RawMechatronicsOrg/EasyScanner/charuco/boards/charuco_A0_10x14_80mm.pdf

## Easy Scanner ChArUco A0: 10 x 14 squares of 80 mm, markers 59.2 mm, DICT_5X5_100

App Settings: squares X 10, squares Y 14, square 80 mm, marker 59.2 mm, dictionary id 5. Print at 100 %, never "Fit to page". 100 mm
