RawMechatronicsOrg/EasyScanner/charuco/boards/charuco_A1_9x13_60mm.pdf

## Easy Scanner ChArUco A1: 9 x 13 squares of 60 mm, markers 44.4 mm, DICT_5X5_100

App Settings: squares X 9, squares Y 13, square 60 mm, marker 44.4 mm, dictionary id 5. Print at 100 %, never "Fit to page". 100 mm
