RawMechatronicsOrg/EasyScanner/cad/assembly/easy_scanner.step

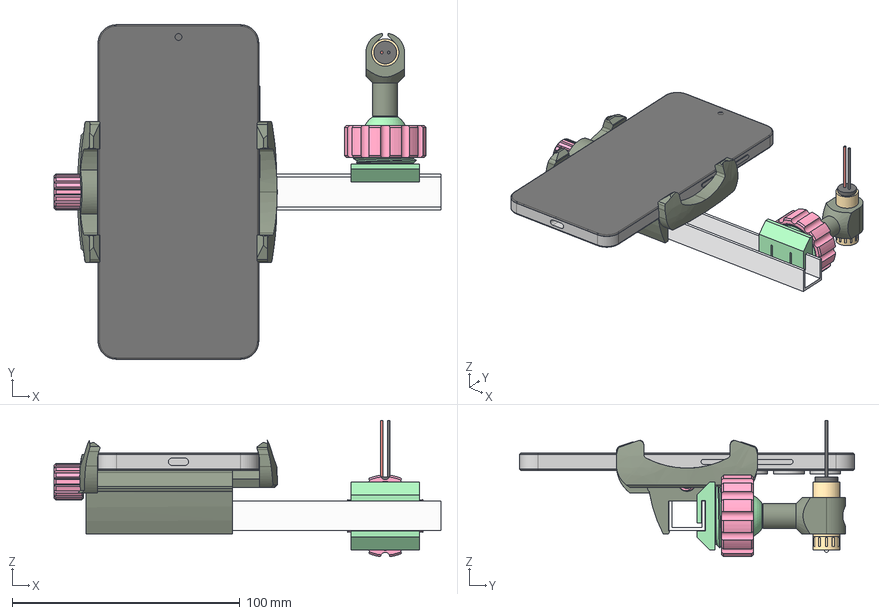
[picture p10: CAD file, 2026-10-28]
cad/assembly/easy_scanner.step
170.0 x 147.0 x 59.9 mm
Phone Clamp Lower
Phone Clamp Upper
S24 body 01
S24 body 02
S24 body 03
S24 body 04
S24 body 05
S24 body 06
S24 body 07
S24 body 08
S24 body 09
S24 body 10
S24 body 11
S24 body 12
Profile 16x13 U
Phone Clamp Screw Bottom
Phone Clamp Screw Top
Phone Clamp Knurled Head
Laser Mount Clip
Laser Mount Ball
Laser Mount Nut
Laser Clamp
Laser body 01
Laser body 02
Laser body 03
Laser body 04
Laser body 05
Laser body 06
