RawMechatronicsOrg/EasyScanner/cad/export/ball_mount_flange_clip.stl

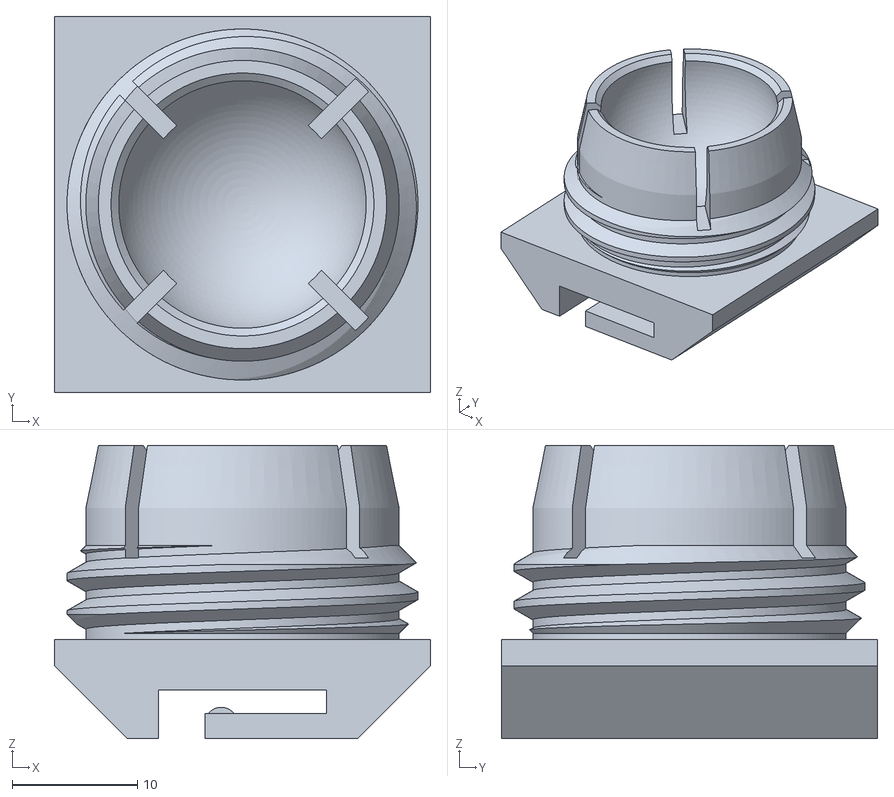
[picture p11: CAD file, 2026-10-28]
cad/export/ball_mount_flange_clip.stl
30.0 x 30.0 x 23.4
