RawMechatronicsOrg/EasyScanner/cad/phone-clamp/export/updated_phone_clamp_upper_no_plate.stl

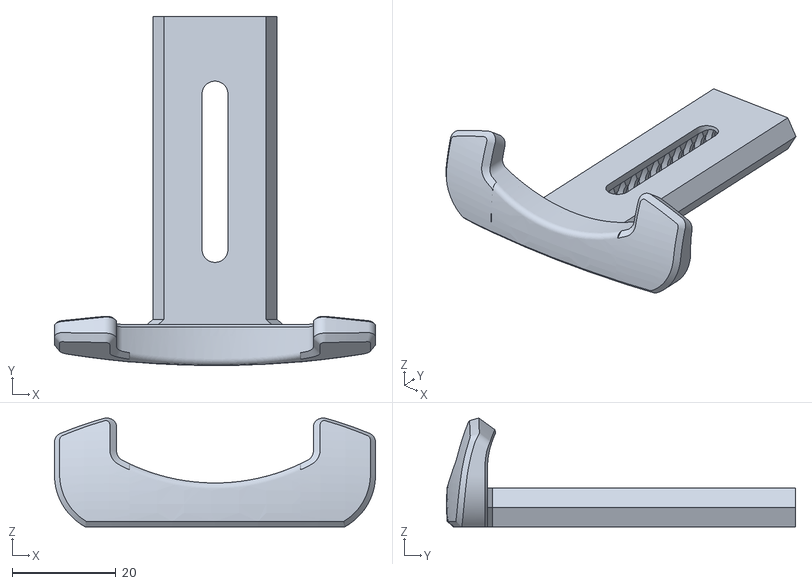
[picture p12: CAD file, 2026-10-19]
cad/phone-clamp/export/updated_phone_clamp_upper_no_plate.stl
62.0 x 67.4 x 21.0
