RawMechatronicsOrg/EasyScanner/cad/export/ball_mount_laser_clamp.stl

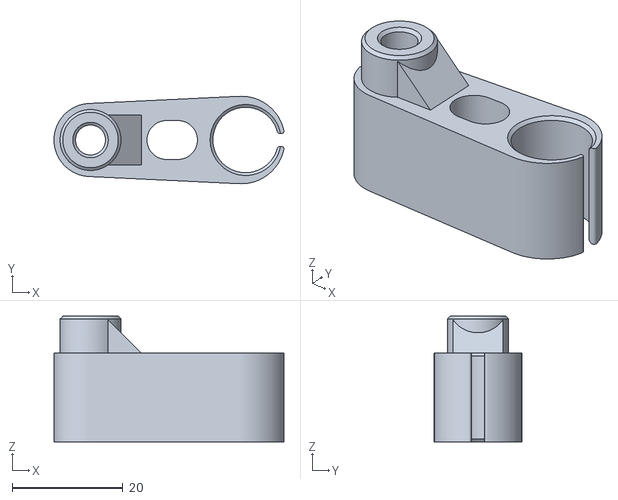
[picture p13: CAD file, 2026-10-19]
cad/export/ball_mount_laser_clamp.stl
41.5 x 15.8 x 22.7
