RawMechatronicsOrg/EasyScanner/cad/phone-clamp/source/updated_phone_clamp_knurl_head_hole.stl

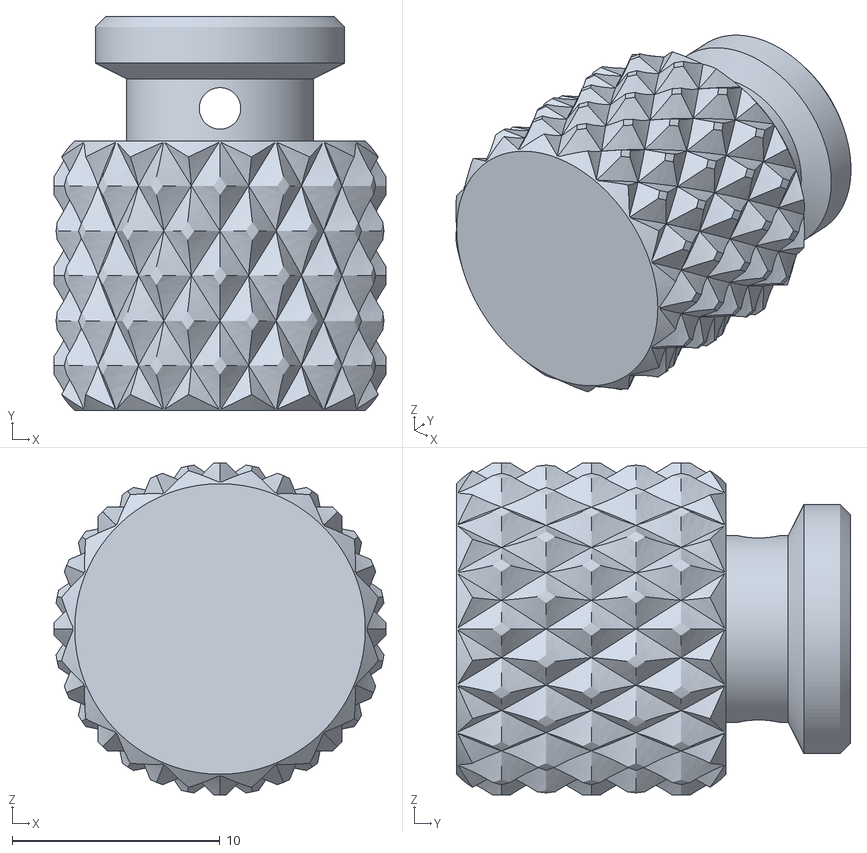
[picture p14: CAD file, 2026-10-19]
cad/phone-clamp/source/updated_phone_clamp_knurl_head_hole.stl
16.0 x 19.0 x 16.0
