RawMechatronicsOrg/EasyScanner/cad/export/ball_mount_ball.stl

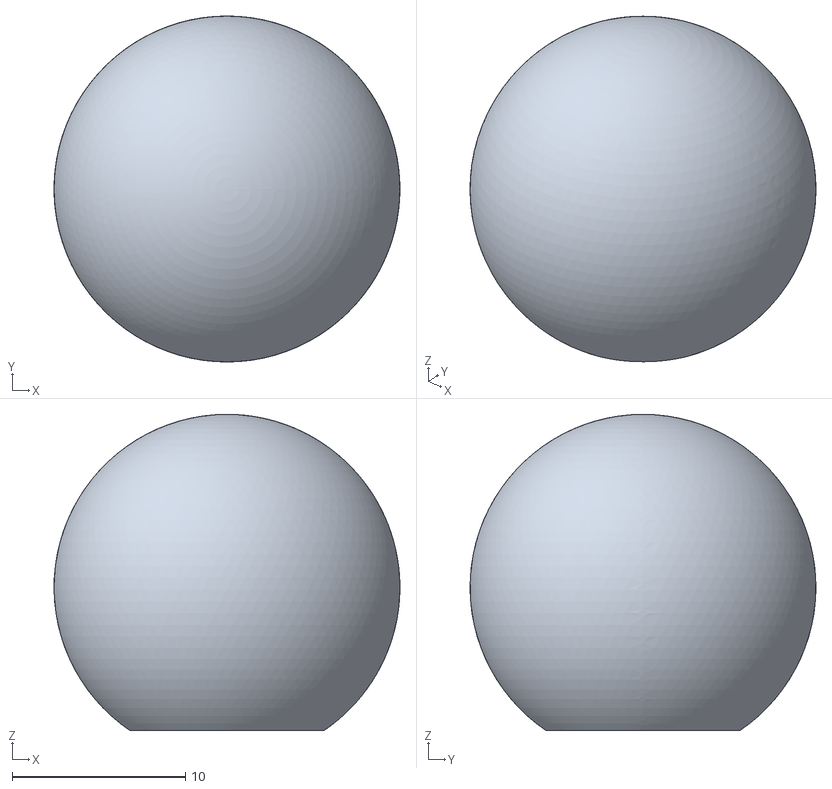
[picture p15: CAD file, 2026-10-19]
cad/export/ball_mount_ball.stl
20.0 x 20.0 x 18.3
