RawMechatronicsOrg/EasyScanner/cad/phone-clamp/export/updated_phone_clamp_lower_profile_slot.stl

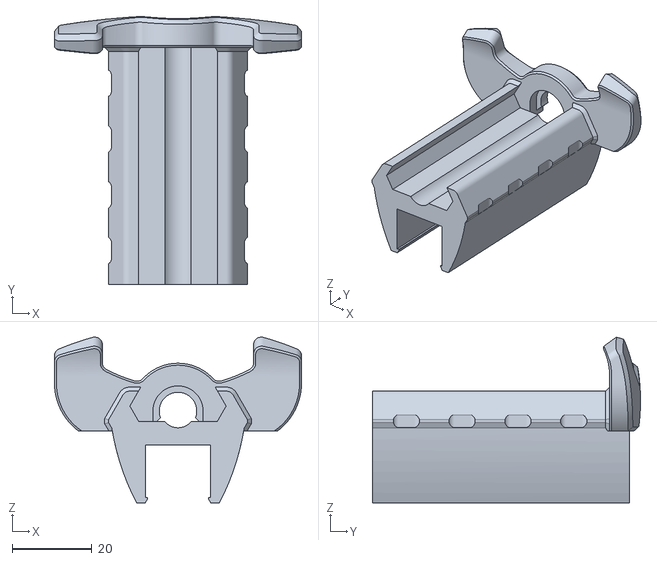
[picture p16: CAD file, 2026-10-19]
cad/phone-clamp/export/updated_phone_clamp_lower_profile_slot.stl
62.0 x 67.2 x 41.6
