RawMechatronicsOrg/EasyScanner/cad/phone-clamp/source/updated_phone_clamp_lower.stl

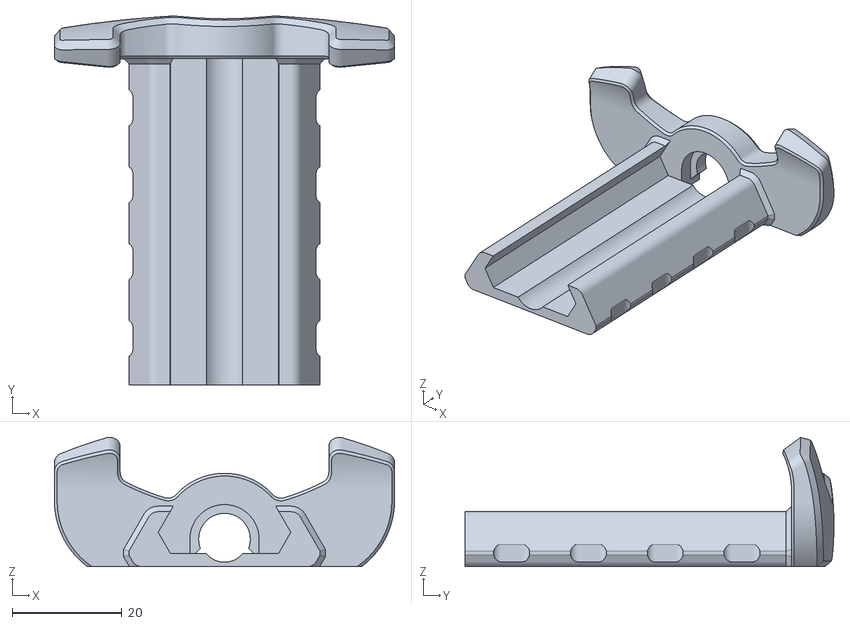
[picture p17: CAD file, 2026-10-19]
cad/phone-clamp/source/updated_phone_clamp_lower.stl
62.0 x 67.2 x 23.5
