RawMechatronicsOrg/EasyScanner/cad/export/ball_mount_laser_clamp_cross.stl

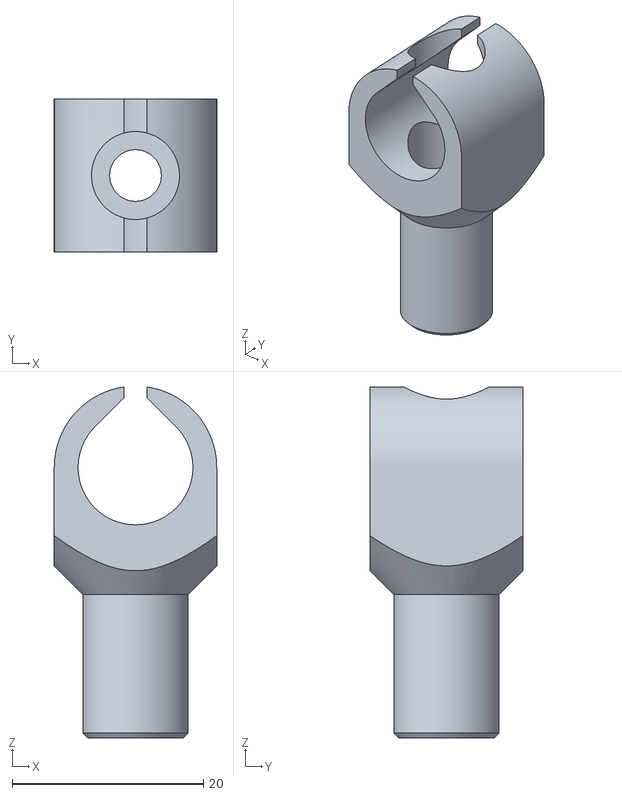
[picture p18: CAD file, 2026-10-19]
cad/export/ball_mount_laser_clamp_cross.stl
17.0 x 16.0 x 36.7
