RawMechatronicsOrg/EasyScanner/cad/phone-clamp/source/updated_phone_clamp_upper.stl

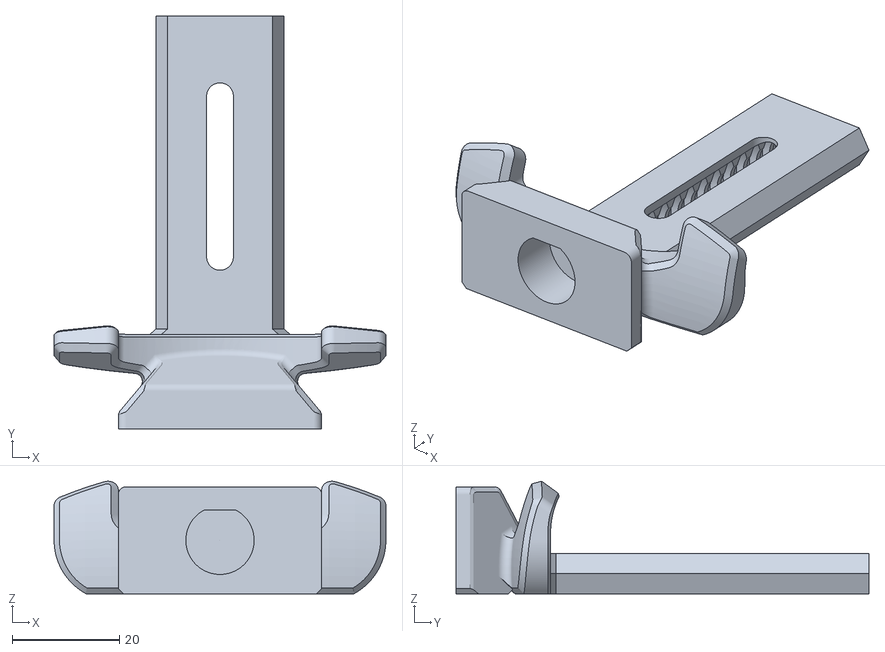
[picture p19: CAD file, 2026-10-19]
cad/phone-clamp/source/updated_phone_clamp_upper.stl
62.0 x 77.2 x 21.0
