RawMechatronicsOrg/EasyScanner/cad/export/ball_mount_clip.stl

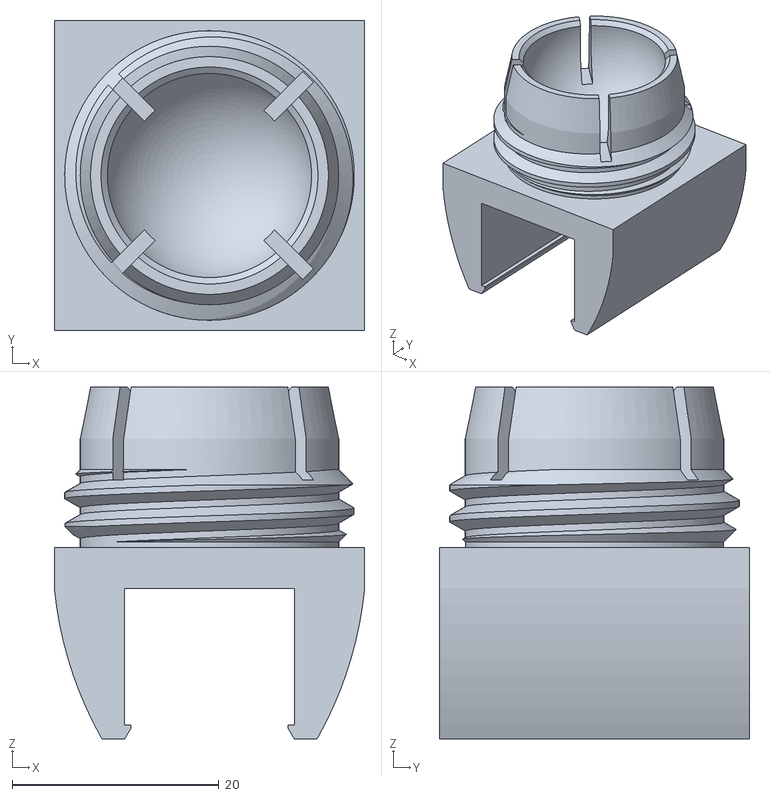
[picture p20: CAD file, 2026-10-19]
cad/export/ball_mount_clip.stl
30.0 x 30.0 x 34.0
