RawMechatronicsOrg/EasyScanner/cad/phone-clamp/source/updated_phone_clamp_screw_top_hole.stl

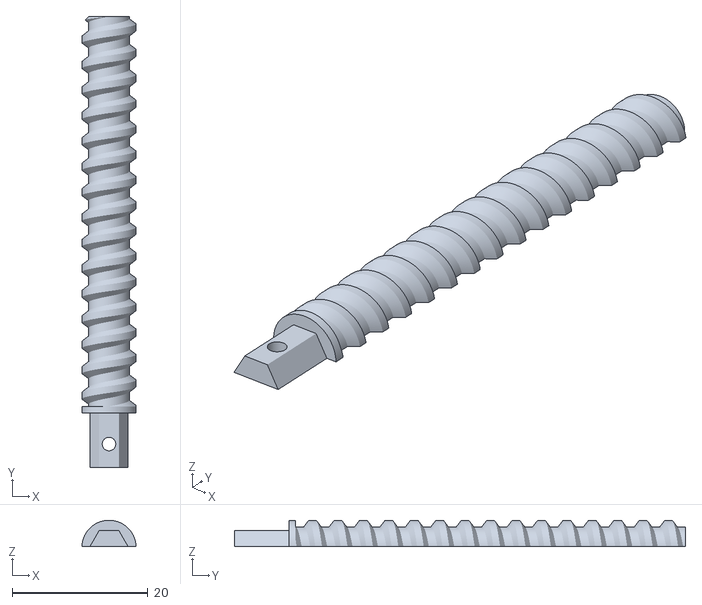
[picture p21: CAD file, 2026-10-19]
cad/phone-clamp/source/updated_phone_clamp_screw_top_hole.stl
8.00 x 66.5 x 3.90
