RawMechatronicsOrg/EasyScanner/cad/export/ball_mount_nut.stl

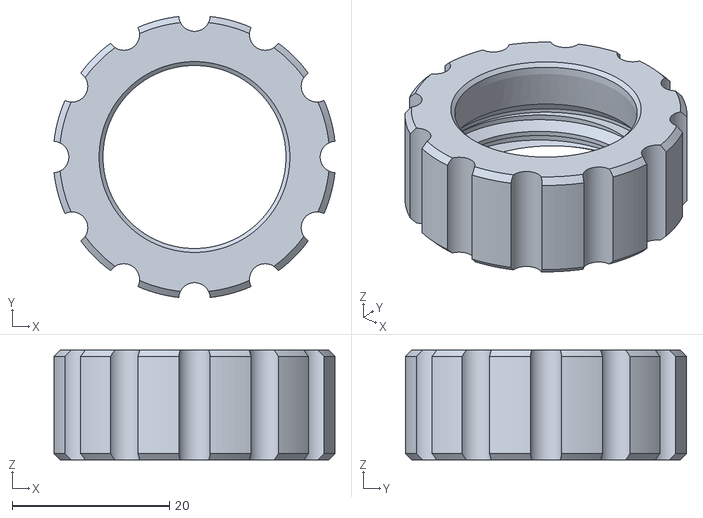
[picture p22: CAD file, 2026-10-19]
cad/export/ball_mount_nut.stl
35.8 x 35.8 x 14.0
