RawMechatronicsOrg/EasyScanner/(list of files, cad)

Other CAD files:
cad/phone-clamp/export/knurled_head_upright.stl
cad/phone-clamp/export/screw_top_print_orientation.stl
cad/phone-clamp/export/screw_bottom_print_orientation.stl
cad/phone-clamp/source/updated_phone_clamp_screw_bottom_hole.stl
cad/assembly/EasyScanner.FCStd
