RawMechatronicsOrg/EasyScanner/charuco/boards/charuco_A2_8x10_45mm.pdf

## Easy Scanner ChArUco A2: 8 x 10 squares of 45 mm, markers 33.3 mm, DICT_5X5_100

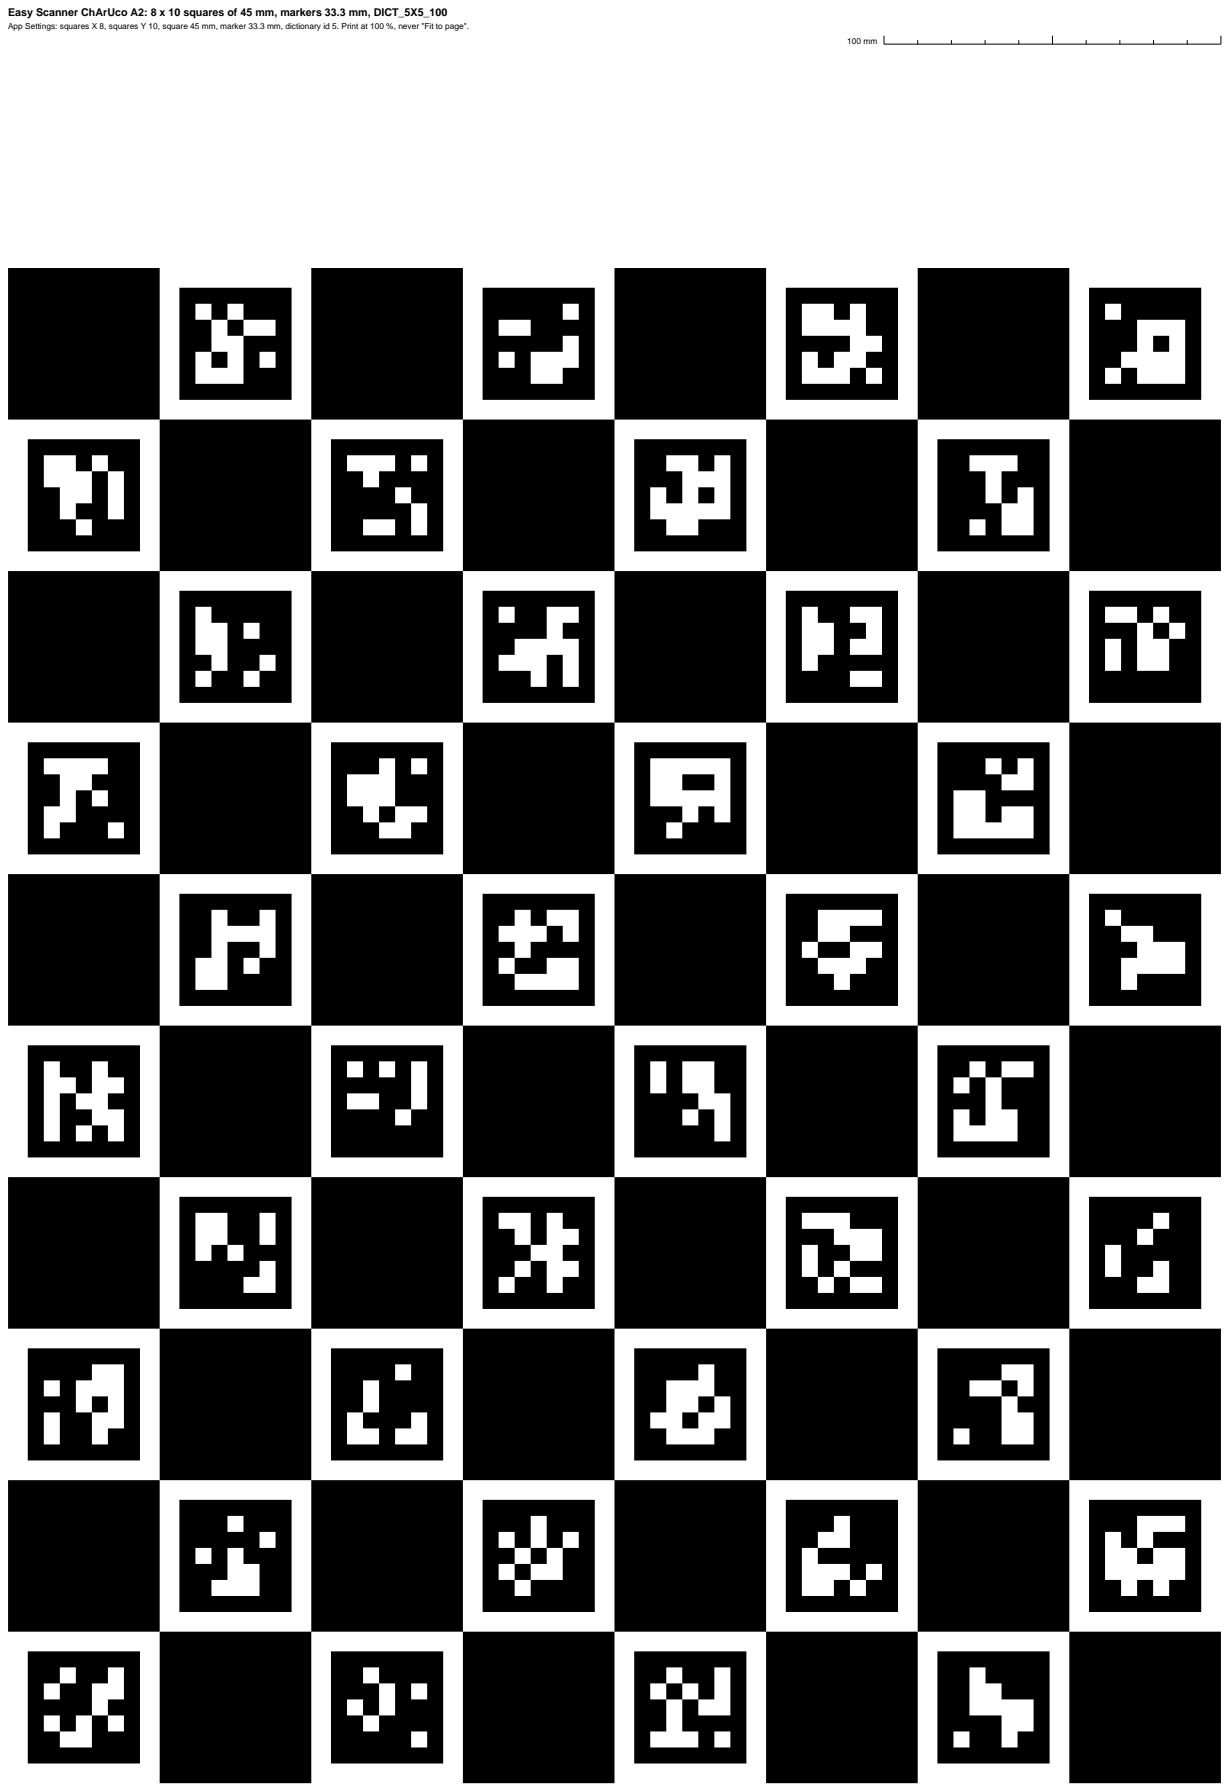
[picture p23: page 1]

App Settings: squares X 8, squares Y 10, square 45 mm, marker 33.3 mm, dictionary id 5. Print at 100 %, never "Fit to page".
