RawMechatronicsOrg/EasyScanner/charuco/boards/charuco_A3_6x8_45mm.pdf

## Easy Scanner ChArUco A3: 6 x 8 squares of 45 mm, markers 33.3 mm, DICT_5X5_100

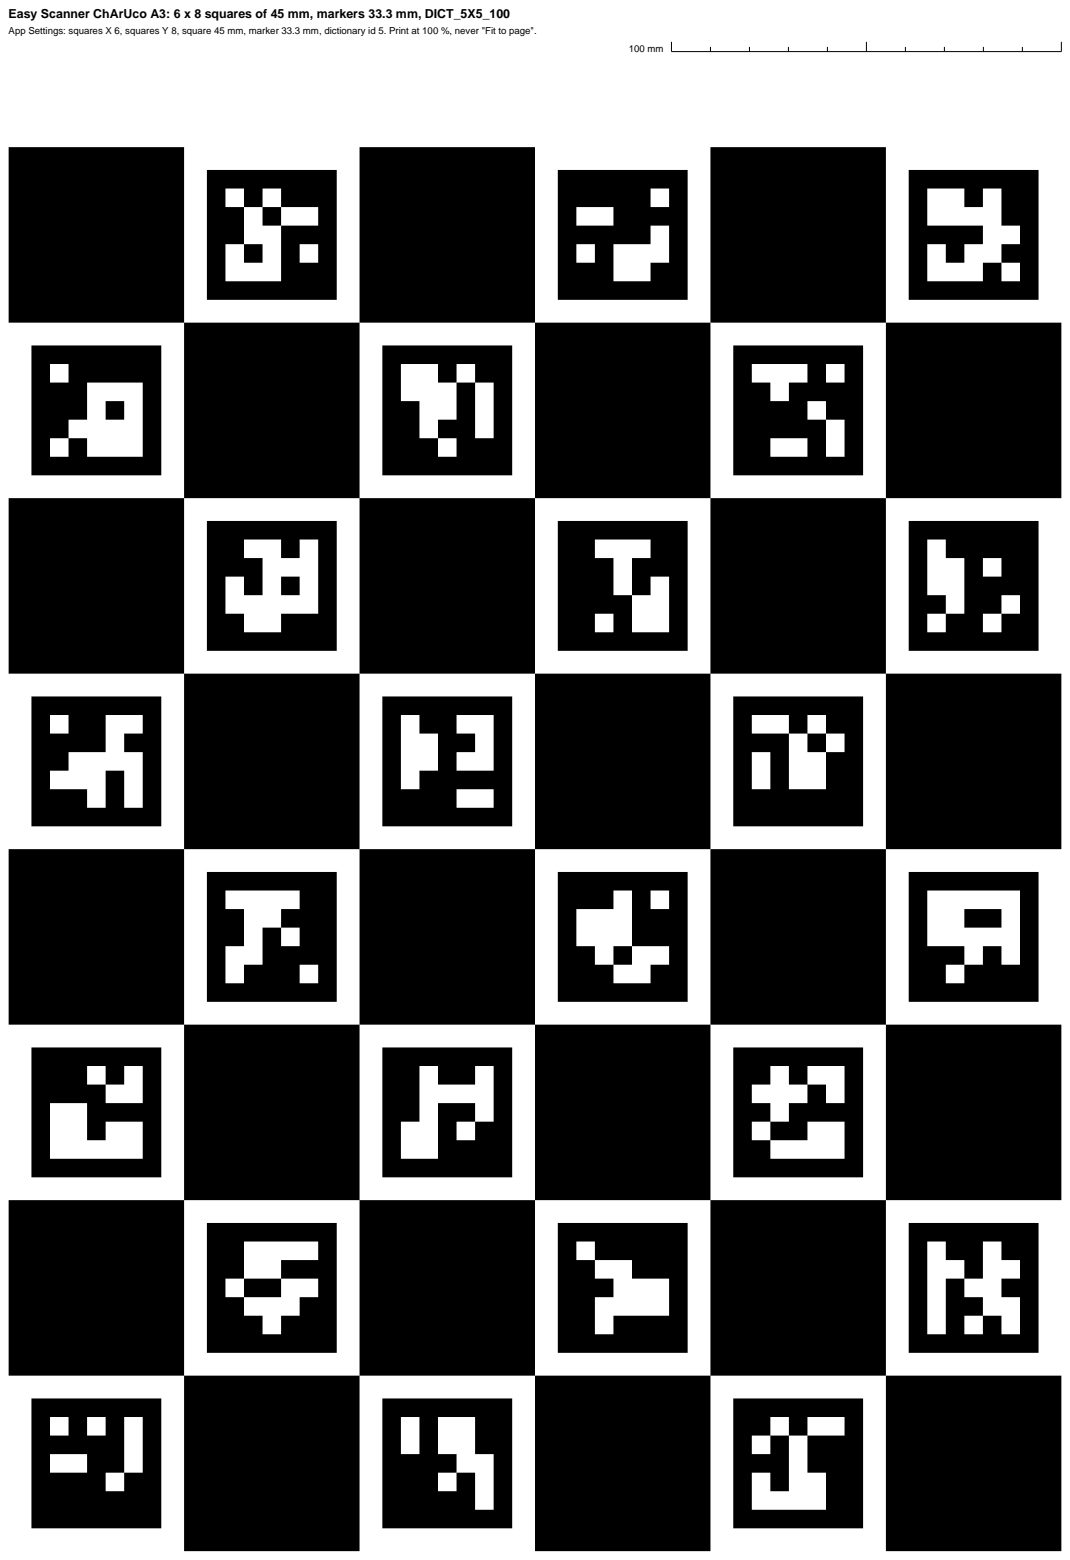
[picture p24: page 1]

App Settings: squares X 6, squares Y 8, square 45 mm, marker 33.3 mm, dictionary id 5. Print at 100 %, never "Fit to page".
