RawMechatronicsOrg/EasyScanner/charuco/boards/charuco_A4_4x6_45mm.pdf

## Easy Scanner ChArUco A4: 4 x 6 squares of 45 mm, markers 33.3 mm, DICT_5X5_100

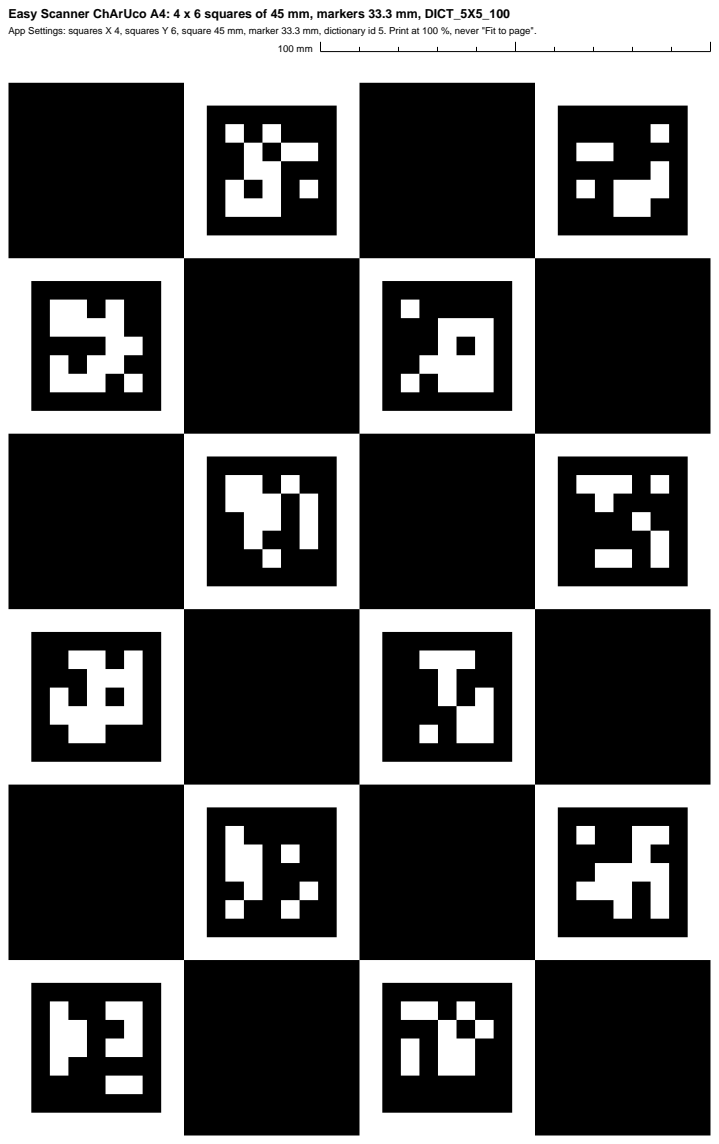
[picture p25: page 1]

App Settings: squares X 4, squares Y 6, square 45 mm, marker 33.3 mm, dictionary id 5. Print at 100 %, never "Fit to page".
