RawMechatronicsOrg/EasyScanner/(commit log)

2026-10-19 v0.1: Easy Scanner — a phone-based laser line scanner and its printable parts
    android/: the Android app (Kotlin UI, Rust core behind JNI with OpenCV
    ChArUco pose, live camera calibration, laser-plane calibration, stripe
    triangulation, PLY export and posed photo keyframes in Orbiter's photo
    session format).
    cad/: the printable parts as CadQuery sources and STL — the profile
    snap-on channel and the ball-head laser mount (CERN-OHL-S-2.0), and the
    phone clamp remixed from Tripod Mobile Phone Clamp V2 by Stamos
    (CC BY-NC-SA 4.0, cad/phone-clamp/).
    [ball_mount_ball.stl, ball_mount_clip.stl, ball_mount_laser_clamp.stl, ball_mount_laser_clamp_cross.stl, ball_mount_nut.stl, knurled_head_upright.stl, screw_bottom_print_orientation.stl, screw_top_print_orientation.stl]
2026-10-28 v0.2: scanner assembly, renders, ChArUco boards A4-A0
    - cad/assembly: the whole scanner (phone dummy, clamp, 16 x 13 U profile,
    ball-head laser mount, schematic line laser) as STEP, FreeCAD and glTF,
    plus the Blender script for the README renders.
    - cad/models/flange_clip.py: the laser mount clip that grips one flange of
    the U profile, as used in the assembly; its STL in cad/export.
    ball_mount.py and profile_clip.py split into reusable pieces for it, the
    other STLs are unchanged byte for byte.
    - charuco/: make_board.py writes true-scale vector PDF boards (any size,
    presets A4-A0, --check detects every corner on the rasterised page) and
    the five ready boards.
    - README: Required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
    [EasyScanner.FCStd, ball_mount_flange_clip.stl, easy_scanner.step]
2026-10-28 v0.2: Z-up PLY export shared from the phone, real-phone status, APK 0.2.0
    - Export writes the cloud Z up over the board (FaceOutFrame::cornered: the
    board frame turned 180 deg about X and shifted by the board height, so the
    object stands on +Z over [0, W] x [0, H]), copies it to
    Download/EasyScanner through MediaStore and opens the share sheet. Ported
    from the uncommitted handscanner-android work of 2026-10-19; photo
    sessions keep their centred frame.
    - README: the app has scanned on a real phone (2026-10-19 screen recording:
    camera and laser-plane calibration, a 254 219-point scan), screenshots and
    the exported cloud; install from the release APK.
    - android/tools/pull-scans.ps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
2026-10-28 v0.2.1: board pose on the Galaxy A23 (two HAL workarounds)
    The overlay drew the board, its corners and the laser stripe far from
    where they were in the preview. Two Samsung HAL quirks behind it:
    - The preview now streams at the analysis size. The A23 scales only to
    the largest stream and cuts smaller YUV streams from its top-left
    corner: a 640x480 analysis frame next to the 1440x1080 preview held
    640x480 pixels of the preview (960x720 likewise), so the engine saw a
    2x zoomed corner of the view. With no stream larger than the analysis
    one, every size is the full view; the photo JPEG stream does not
    bring the crop back.
    - LENS_INTRINSIC_CALIBRATION is [3125, 3125, 0, 0, 0] there: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
2026-10-28 v0.3.0: guided steps, and a scan that is never lost
    The screen now leads through what a scan needs: Board (pick the printed
    board, confirm it in view; markers without corners say the settings do
    not match the print), Focus (lock the lens where autofocus settled, or
    at the saved calibration's focus), Camera, Laser plane, Scan, Saved.
    Each step is done when its state holds and moves on by itself; one whose
    prerequisite breaks comes back (Wizard.kt, unit-tested). Settings ->
    Expert mode keeps the four tool modes.
    Nothing is lost on the way:
    - A guided scan always runs in a session (photos on by default, or a
    scan-only session). The engine writes the cloud into it (laser.ply for
    orbiter-rec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
2026-10-28 e2e: run on the Galaxy A23, fix the photo-failure test's check
    The engine e2e tests now ran on a real arm64 phone: 7/7 after this fix.
    The failing-photos test asserted that PHOTOS_OFF removes a pending still
    the test had written straight to disk; the engine only drops stills the
    app registered with PHOTO_ADD, and the unposed file goes with the empty
    session on close, which the test still checks.
    [e2e_tests.rs]
2026-10-30 v0.3.1: view the scans on the phone, their clouds and photos
    - Scans (the gallery button next to Settings): every session in
    files/sessions/ and expert-mode export in files/scans/, newest first,
    with its point count and photos (ScanLibrary.kt).
    - A scan opens on its cloud: OpenGL ES 2 points in their own colours
    (scan.ply, else laser.ply; over 1.5 M points thinned by a stride), one
    finger orbits about the cloud's median, two fingers zoom and pan, a double
    tap frames it again (CloudView.kt). PlyCloud.kt reads any binary
    little-endian PLY; unit-tested.
    - The session's photos sit under it; a tap shows one full screen, turned the
    way the live preview showed it (EXIF turn, else the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
